TXY-2106/Mid-term-internship-10.1/firmware/esp32/qsm_monitor/README.md

# ESP32 网关（Arduino IDE）

功能：接收 STM32 的 `$QSM` 帧 → 连 Wi-Fi → 托管网页仪表板。**不做任何计数判定**。

## 环境准备

1. Arduino IDE → 文件 → 首选项 → 附加开发板管理器网址，填（国内镜像，走 `dl.espressif.cn`）：

   ```
   https://arduino.me/packages/esp32.json
   ```

2. 工具 → 开发板 → 开发板管理器 → 搜索 `esp32` → 安装 **esp32 by Espressif Systems `3.2.1-cn`**
3. 开发板选 **ESP32 Dev Module**，端口选 CH340 对应的 COM 口

> 镜像最高为 3.2.1，比官方 3.3.12 旧一个小版本，本项目功能不受影响。注意 ESP32 core **3.x 与 2.x 的部分 API 有差异**，查文档时看清版本。

## 打开与修改

1. 用 Arduino IDE 打开 `qsm_monitor/qsm_monitor.ino`（草图中所有 `.h/.cpp` 会一起编译）
2. 在 **`config.h`** 里选联网方式（**只改这一个数**）：

   ```c
   #define WIFI_MODE       1     /* 1=自建热点  2=连现场Wi-Fi  3=两者同时 */
   ```

   | 模式 | 地址 | 什么时候用 |
   |---|---|---|
   | `1` AP（**默认**） | `http://192.168.4.1` **永远不变** | **演示**：不依赖现场网络，插电就能用 |
   | `2` STA | 路由器分配的 IP，看串口打印 | 平时开发、要上网 |
   | `3` APSTA | 两者都有，热点兜底 | 想连现场网又怕连不上 |

   选 `2` 或 `3` 才需要填 `WIFI_SSID` / `WIFI_PASSWORD`；选 `1` 不用填任何 Wi-Fi。

   > **演示建议用模式 `1`**：ESP32 自己开热点 `QSM-Monitor`（密码 `qsm12345`），
   > 手机或笔记本连上它，浏览器打开 `http://192.168.4.1` 即可。
   > 这样你在**任何一台电脑上烧录一次**，之后插电就能演示，不用串口、不用找 IP、不依赖场地 Wi-Fi。
   > 手机若提示"此 WLAN 无法访问互联网"，选**保持连接**即可。

3. 上传

## 接线

依据仓库 [`hardware/硬件接线说明.md`](../../../hardware/硬件接线说明.md)：

| ESP32 | STM32 | 说明 |
|---|---|---|
| GPIO16 (U2RXD) | **PA2** (USART2_TX) | STM32 → ESP32 |
| GPIO17 (U2TXD) | **PA3** (USART2_RX) | ESP32 → STM32 |
| GND | GND | **必须共地** |
| Type-C | — | 充电宝供电（USB-A 转 Type-C） |
| VIN | 5V | 由 ESP32 的 VIN 分出 5V 给 STM32 / E18×4 / SD 卡座 |

> **不要**把 ESP32 的 3V3 与 STM32 的 3V3 并联；**不要**给 STM32 插 Type-C。
> ESP32 发射瞬时电流可达 300 mA，务必由充电宝独立供电并在模块旁加 470 µF 电容，否则会复位。

## 使用

上传后打开串口监视器（115200），会看到一张启动横幅，例如模式 `1` 时：

```
========================================
  排队状态监测器 已启动
  热点: QSM-Monitor   密码: qsm12345
  打开: http://192.168.4.1
  (手机提示"无互联网"时选"保持连接")
========================================
[QSM] http server started on port 80
```

模式 `2` / `3` 连上现场 Wi-Fi 时还会多打印一行 `[WiFi] connected, open http://192.168.x.x`。

**演示流程（模式 1，全程不需要电脑）**：

1. 充电宝给 ESP32 供电（Type-C），ESP32 的 VIN 分出 5V 给 STM32 / E18 / SD 卡
2. 手机或笔记本连 Wi-Fi `QSM-Monitor`，密码 `qsm12345`
3. 浏览器打开 `http://192.168.4.1`

浏览器即可看到仪表板：三级状态色块、在场人数、累计进出、两路探头遮挡时长、最近 2 分钟趋势条、拥挤告警。

> 若装了 Bonjour，也可以访问 `http://qsm.local`；**不确定就还是用 IP，IP 永远可用**。

## 现场常见问题

| 现象 | 原因 / 处理 |
|---|---|
| 手机连上热点却打不开 `192.168.4.1` | 手机把该热点当成"无互联网 WLAN"自动切回流量，关掉移动数据或选"保持连接" |
| 换了场地，`192.168.4.1` 打不开 | 你烧的是模式 `2`（STA），IP 变了；改回模式 `1` 重烧 |
| 网页一直显示"等待数据" | STM32 没在发帧：查 PA2→GPIO16 接线、共地、STM32 是否已烧录 |
| 热点开了但搜不到 | 密码少于 8 位会开热点失败，`AP_PASSWORD` 至少 8 个字符 |

## HTTP 接口

| 路径 | 说明 |
|---|---|
| `/` | 仪表板网页（内嵌，无外部依赖，断网可用） |
| `/api/state` | 最新状态 JSON，含链路统计与告警阈值 |

`/api/state` 示例：

```json
{"valid":true,"seq":1024,"ms":3735000,"datetime":"2026-10-28T12:31:04",
 "in":37,"out":29,"occ":8,"q50":6100,"q100":0,"grade":2,"flags":3,
 "good":1024,"bad":0,"age":450,"alert_grade":2,"alert_occ":8}
```

`good` / `bad` / `age` 三个字段是现场排障用的：`bad` 持续增长说明串口干扰或两端协议不一致，`age` 过大说明 STM32 掉线或没在发。

## 文件说明

| 文件 | 职责 |
|---|---|
| `qsm_monitor.ino` | 入口：初始化、主循环、Wi-Fi 后台重连 |
| `config.h` | Wi-Fi、串口引脚、历史长度、告警阈值 |
| `serial_link.cpp/.h` | 帧解析 + CRC8 校验（须与 `firmware/core/protocol.c` 一致） |
| `web_server.cpp/.h` | HTTP 路由与 JSON 序列化 |
| `web_page.h` | 内嵌 HTML/CSS/JS（单页，1 s 轮询） |

## 注意

- **CRC 算法两端必须一致**：改 `firmware/core/protocol.c` 的 `qsm_crc8` 时，必须同步改 `serial_link.cpp` 的同名函数。
- 网页用 1 s 轮询而非 WebSocket/SSE，是为了让整页逻辑足够短、便于现场排障；A3 要求 ≤5 s，余量充足。
- `config.h` 里的 `HISTORY_SIZE` 目前未用于服务端历史（趋势条在前端生成）；若要在服务端存 1 小时历史，需要再加环形缓冲与 `/api/history` 接口。
