TXY-2106/Mid-term-internship-10.1/docs/排队状态监测器——后期测试方案.docx

## 排队状态监测器——后期测试方案

项目名称：排队状态监测器

项目阶段：软件测试分析与后续实物测试准备

个人主要分工：后期测试、测试用例设计与测试结果整理

一、测试目的

通过分析测试代码，了解系统对人员进出方向、排队拥挤程度及通信数据的处理方式，整理对应的测试用例和预期结果，为后续四路红外传感器安装完成后的系统联调与实际场景测试提供依据。

二、项目当前测试基础

项目计划采用四路 E18-D80NK 红外光电传感器，其中两路用于判断人员进出方向，另外两路分别设置在队伍长度约50%和100%的位置，用于判断队伍拥挤程度。STM32 负责采集和处理传感器信号，ESP32 负责通信及网页展示。

目前已完成网页基本功能及单个红外传感器与 STM32 的初步连接，四路传感器的完整安装和系统联调仍需继续推进。

小组 GitHub 仓库已建立软件单元测试框架，主要包含以下文件：

1. test_gate_counter.c：用于测试人员进入、离开、重复触发、超时及方向判断等逻辑。

2. test_queue_grade.c：用于测试排队状态分级、状态切换延迟及异常情况处理。

3. test_protocol.c：用于测试通信数据编码、解析及 CRC 校验。

4. test_main.c：用于组织各模块测试并统计检查次数与失败次数。

5. test_util.h：提供 CHECK 和 CHECK_EQ 等测试判断工具。

6. Makefile：用于编译和运行软件单元测试。

根据 GitHub 项目 README 中的记录，现有软件测试共完成53项检查，记录结果为0项失败。该结果属于软件逻辑测试记录，不能直接代表完整硬件系统的实际测试结果。

三、软件测试用例设计

3.1 人员进出统计测试

编号 | 测试场景 | 测试操作或输入 | 预期结果
01 | 正常进入 | 依次触发入口检测区域的A、B两路信号 | 进入人数增加1
02 | 正常离开 | 按相反顺序触发B、A两路信号 | 离开人数增加1
03 | 触发间隔超时 | 两路信号间隔超过设定识别时间 | 不产生有效进出计数
04 | 单路信号触发 | 仅触发一路信号，另一信号未触发 | 超时后不计数
05 | 同一路重复触发 | 同一路信号在短时间内重复触发 | 不产生错误的完整进出计数
06 | 恢复遮挡过程 | 模拟传感器遮挡后恢复的信号变化 | 不因恢复过程错误改变进出方向
07 | 方向配置反转 | 修改方向配置并输入相同触发顺序 | 进出方向按照配置正确变化
08 | 离开人数多于进入人数 | 在当前人数为0时模拟离开 | 当前在场人数不小于0

3.2 排队拥挤程度分级测试

系统设计将排队状态划分为“较少、约半、全满”三级。

编号 | 测试场景 | 测试操作或输入 | 预期结果
09 | 初始状态 | 初始化排队分级模块 | 显示“较少”
10 | 50%位置持续遮挡 | 模拟中部传感器持续被遮挡 | 达到设定持续时间后变为“约半”
11 | 100%位置持续遮挡 | 模拟末端传感器持续被遮挡 | 达到设定条件后变为“全满”
12 | 短时间遮挡 | 遮挡时间未达到设定阈值即恢复 | 不因短暂经过而错误升级
13 | 遮挡解除 | 模拟传感器从遮挡恢复到未遮挡 | 达到设定释放时间后调整状态
14 | 状态交叉校验 | 末端传感器遮挡，但实际在场人数不足 | 记录冲突，不直接错误

判定为全满

3.3 通信协议测试

15 | 正常编码 | 输入合法人数、时间及状态数据 | 生成符合协议格式的数据帧
16 | 正常解析 | 输入符合格式的数据帧 | 正确解析对应字段
17 | CRC校验 | 输入包含正确CRC的数据帧 | 校验通过
18 | 数据损坏 | 修改数据内容但不更新CRC | 识别校验错误
19 | 非法输入 | 输入错误格式或不完整的数据帧 | 拒绝非法数据，避免错误更新状态

四、后续真实硬件测试计划

由于四路红外传感器尚未完成整体安装，本部分主要用于后续实物联调阶段。

编号 | 测试项目 | 测试方法 | 预期结果
01 | 单人进入测试 | 一人按正常方向通过检测区域 | 人数正确增加
02 | 单人离开测试 | 一人按相反方向通过检测区域 | 人数正确减少
03 | 连续通过测试 | 多人依次通过检测区域 | 计数与实际人数一致
04 | 两人并排测试 | 两人同时通过检测区域 | 记录实际识别结果，分析漏计或误计情况
05 | 通信异常测试 | 模拟ESP32断线、重连等情况 | 检查通信恢复及数据显示情况
06 | 网页状态核对 | 对照真实人数和传感器状态查看网页 | 显示结果与实际状态相符，记录更新延迟

以上测试需要在真实硬件条件具备后开展。测试过程中应记录实际结果，不能仅根据软件逻辑推断硬件测试通过。

五、个人测试记录表

测试日期 | 测试编号 | 测试环境 | 预期结果 | 实际结果 | 是否通过 | 问题及证据

六、当前存在的问题及后续安排

1. 四路红外传感器尚未完成整体安装，真实环境下的进出计数与排队分级准确性仍需验证。

2. 软件单元测试采用模拟输入，尚不能反映实际传感器受安装距离、人员速度和并排行走影响时的识别情况。

3. 网页显示与真实传感器数据之间的完整联动效果、更新延迟及长时间运行稳定性仍需进一步确认。

4. 后续计划配合小组完成硬件联调，按照测试用例开展重复实验，记录实际人数、系统计数、显示状态和异常现象，并对发现的问题进行复测。
