TXY-2106/Mid-term-internship-10.1/docs/排队状态监测器项目中期评审会议纪要.docx

## 排队状态监测器项目中期评审会议纪要

项目名称： 排队状态监测器

小组： 第一组

会议时间：2026年10月31日（第九周周六）

会议地点：电气楼330

会议形式：项目中期进度汇报与教师评审

参会人员：小组全体成员：谭心宇、叶明昌孝、丁秋月、张岩超

指导教师：崔磊磊

记录人： 丁秋月

一、会议主要内容

本次会议主要围绕排队状态监测器项目的阶段性开发成果、当前存在的问题以及后续改进方向展开。小组通过PPT汇报了项目背景、功能需求、软硬件设计方案、人员分工、当前开发进度及后续测试计划，并听取了指导教师的意见。

二、项目当前进展

1.系统设计方面： 项目采用红外传感器进行非图像式检测，以保护用户隐私。计划使用四个红外传感器，其中入口设置两个，用于辅助判断人员进出；队伍中间和末端各设置一个，用于判断队伍的排队状态。

2.硬件开发方面： 已完成一个红外传感器与STM32主板的连接，其他传感器尚未完成安装。系统设计中还包括ESP32通信模块、DS3231时钟模块及SD卡存储模块。

3.软件开发方面： 已完成网页基本功能，实现排队人数及“少、一半、满”三档状态的显示。

4.阶段性测试方面： 已打通单个红外传感器、STM32、ESP32与网页之间的基本数据传输链路。在单传感器台架测试中，进行了10次挥手触发测试，10次均正确计数。

5.当前存在的问题： 网页更新存在约4—5秒的延迟，四个红外传感器尚未完成整体安装，三档状态准确率及系统连续运行稳定性仍需进一步验证。

6.目前已建立软件单元测试框架，覆盖进出人数统计、排队拥挤程度分级和通信协议等功能；GitHub 项目文档记录53项检查通过，后续仍需结合完整硬件开展实际场景测试。

三、指导教师提出的意见

1.增加排队情况预测功能

指导教师建议在现有排队状态监测功能的基础上，进一步考虑预测排队情况，使系统不仅能够显示当前队伍状态，还能够为用户提供未来排队变化或等待情况的参考。

2.优化硬件安装与连接方式

指导教师建议将四个红外传感器的连接集中到统一电路板上，采用焊接方式进行固定，减少分散接线，提高硬件结构的整洁性、稳定性和后续维护便利性。具体采用PCB还是洞洞板，需进一步确认。

3.增加现场显示方式

指导教师建议在现有网页显示功能的基础上，考虑增加实体显示屏，使现场排队人员也能够直接查看当前排队人数及状态，提高系统在实际排队场景中的实用性。

四、小组讨论与初步改进方向

针对教师提出的意见，小组拟在保留现有系统基本功能的前提下，进一步完善软硬件设计。

在功能方面，研究排队预测功能的实现方式，结合人数变化和排队速度等信息，评估是否能够提供预计等待时间或排队趋势。

在硬件方面，进一步讨论四个红外传感器的集中安装方式，完善接线布局，并优先完成四路传感器的连接与调试。

在显示方面，研究现有网页与实体显示屏结合的可行性，考虑使用适合现场观看的显示设备，展示排队人数及三档状态。

同时，继续解决网页更新延迟问题，逐步开展准确率、异常情况和系统稳定性测试。

五、会议总结

通过本次中期评审，小组明确了项目当前取得的阶段性成果和仍需解决的问题。指导教师的意见为后续功能拓展、硬件结构优化和实际应用场景设计提供了方向。

下一阶段，小组将优先完成四路传感器安装、数据传输优化和系统功能测试，并根据开发时间与实际条件评估预测功能和现场显示屏的实现可行性。
