TXY-2106/Mid-term-internship-10.1/hardware/制版文件/2D平面图.png

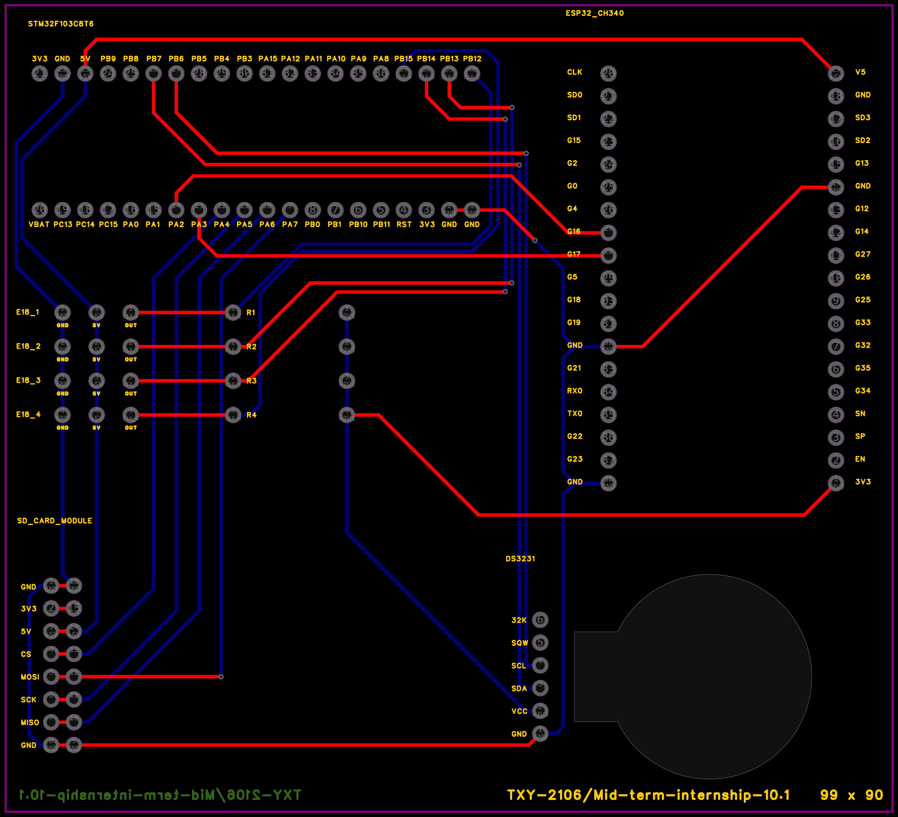
hardware/制版文件/2D平面图.png
