TXY-2106/Mid-term-internship-10.1/docs/post-testing plan.docx

## Queue status monitor—post-testing plan

Project Name: Queue Status Monitor

Project phase: software testing analysis and subsequent physical testing preparation

My main responsibilities: post-stage testing, designing test cases, and organizing test results

1. Purpose of the Test

By analyzing the test code, the system understands how the system handles personnel entry and exit directions, queue congestion, and communication data, organizes corresponding test cases and expected results, and provides a basis for system joint debugging and real-world testing after the installation of four infrared sensors

2. Current testing foundation for the project

The project plans to use four E18-D80NK infrared photoelectric sensors: two to determine the direction of personnel entering and exiting, and the other two to be set at about 50% and 100% of the queue length respectively to assess crowding levels. STM32 is responsible for collecting and processing sensor signals, while ESP32 is responsible for communication and web display

Currently, basic web functions and the initial connection of a single infrared sensor to STM32 have been completed. The complete installation of four sensors and system integration still require further progress

The group GitHub repository has established a software unit testing framework, mainly consisting of the following files:

1. test_gate_counter.c: Used to test logic such as personnel entering, leaving, repeated triggers, timeouts, and direction judgment.

2. test_queue_grade.c: Used to test queue status grading, state switching delay, and exception handling.

3. test_protocol.c: Used for testing communication data encoding, parsing, and CRC verification.

4. test_main.c: Used to organize testing for each module and count the number of inspections and failures.

5. test_util.h: Provides test and judgment tools such as CHECK and CHECK_EQ.

6. Makefile: Used for compiling and running software unit tests.

According to the records in the GitHub project README, a total of 53 checks have been completed in the existing software test, with zero failures. These results belong to software logic test records and cannot directly represent the actual test results of the complete hardware system.

3. Software Test Case Design

3.1 Personnel entry and exit statistical testing

Number | Test scenario | Test operations or inputs | Expected results
01 | Normal entry | Trigger signals A and B in sequence at the entrance detection area | Number of entrants increased by 1
02 | Leave as usual | Trigger signals B and A in reverse order | Number of departures increased by 1
03 | Trigger interval timeout | The interval between two signals exceeds the set recognition time | No effective in-exit count is generated
04 | Single-channel signal trigger | Only one signal is triggered; the other signal is not triggered | Beyond the time limit is not counted
05 | Trigger the same path repeatedly | The same signal is repeatedly triggered within a short period | No incorrect complete in-out counts are produced
06 | Restore the occlusion process | Analog signal changes after sensor occlusion | Do not change the direction of entry and exit due to errors during the recovery process
07 | Directional configuration reversal | Modify the direction configuration and enter the same trigger sequence | The direction of entry and exit changes according to the correct configuration
08 | More people left than entered | Simulate leaving when the current number of players is 0 | The current number of attendees is no less than 0

3.2 Grading Test for Queue Crowd Level

The system design divides queue status into three levels: "Smaller," "About Half," and "Fully Full."

Number | Test scenario | Test operations or inputs | Expected results
09 | Initial state | Initialize the queue grading module | Show "Less"
10 | 50% of the area remains occluded | The simulated central sensor is continuously obscured | After reaching the set duration, it becomes "about half"
11 | 100% position continuously occluded | The analog end-point sensor is continuously obscured | After meeting the set conditions, it becomes "fully full"
12 | Cover for a short time | Restoration occurs before the occlusion time reaches the set threshold | Do not upgrade mistakenly just because of a brief pass
13 | Obstruction removed | The analog sensor recovers from occlusion to unmasked | Adjust the status after reaching the set release time
14 | Status cross-check | The terminal sensors are obstructed, but the actual number of people present is insufficient | Record conflicts, do not make direct mistakes

The judgment was fully booked

3.3 Communication protocol testing

15 | Normal encoding | Enter the number of legitimate people, time, and status data | Generate data frames that comply with protocol format
16 | Normal analysis | Enter data frames that match the format | Correctly parse the corresponding fields
17 | CRC verification | Enter a data frame containing the correct CRC | Verification passed
18 | Data corruption | Modifying data content but not updating CRC | Identify validation errors
19 | Illegal input | Incorrect formatting or incomplete data frames | Reject illegal data to avoid erroneous state updates

4. Subsequent real hardware testing plans

Since the overall installation of the four infrared sensors has not yet been completed, this section is mainly used for the subsequent physical integration phase.

Number | Test items | Testing methods | Expected results
01 | Single-entry testing | One person passes through the inspection area in the normal direction | The number of people has increased correctly
02 | Solo leave for testing | One person passes through the inspection area in the opposite direction | The number of people is rightly reduced
03 | Passing tests continuously | Multiple people passed through the inspection area in sequence | The count matches the actual number of people
04 | Two people tested side by side | Both passed through the inspection area simultaneously | Record the actual recognition results and analyze any undercounts or errors
05 | Communication anomaly testing | Simulating ESP32 disconnection and reconnection scenarios | Check communication recovery and data display
06 | Web page status check | View the webpage against the actual number of people and sensor status | The display results match the actual status, and the update delay is recorded

The above tests must be conducted only after actual hardware conditions are met. The actual results should be recorded during testing; passing hardware tests should not be inferred solely based on software logic.

5. Personal Test Record Sheet

Test date | Test number | Testing environment | Expected results | The actual result | Whether it passes | Issues and evidence

6. Current Issues and Follow-up Arrangements

1. The four-channel infrared sensors have not yet been fully installed; the accuracy of entry and exit counting and queue grading in real environments still needs to be verified.

2. Software unit tests use analog inputs and cannot yet reflect the recognition of actual sensors affected by installation distance, personnel speed, and parallel walking.

3. The complete linkage between webpage display and real sensor data, update delay, and long-term operation stability still require further confirmation.

4. Subsequent plans include cooperating with the team to complete hardware joint debugging, conduct repeated experiments according to test cases, record actual number of people, system counts, display status and abnormal phenomena, and retest any issues found.
