TXY-2106/Mid-term-internship-10.1/(commit log)

2026-09-26 补充项目概要、验收标准与时间线
    Updated the README to reflect project details and acceptance criteria in Chinese.
2026-09-26 添加英文版 README（README.en.md）
2026-09-26 README 顶部添加中英双语切换标签
2026-10-12 同步已确定的技术方案、docs 跳转链接，A1 调整为 ≤ ±2 人
    Updated project details and acceptance criteria in README.md. Added technical solution section and refined privacy compliance criteria.
2026-10-13 技术方案修正：热成像改为红外线识别
    Updated project details and technical方案 in README.
2026-10-23 重写 README：对齐当前红外 + 双板方案，移除时间线，新增成本控制
2026-10-23 改用大卡 SD 模块与自有 32GB 卡，更新成本估算
2026-10-23 SD 卡按市面价列示但不计入合计；补充容量测算与 8GB 推荐
2026-10-23 List SD card at market price but exclude from total; add capacity estimate and 8 GB recommendation
2026-10-23 标题改为排队状态监测器
2026-10-26 Create hardware wiring instructions document
    Added detailed hardware wiring instructions for STM32F103C8T6, ESP32-WROOM-32, E18-D80NK, DS3231, and SD card module.
2026-10-26 Create Hardware Wiring Instructions document
    Added detailed wiring instructions for STM32, ESP32, and peripherals including power connections, pin assignments, and module wiring.
2026-10-27 README 改为折叠式；新增硬件与文档索引入口；清理合并残留
2026-10-27 项目概要前四块常显；用户与受益者移至项目任务后；其余内容折叠
2026-10-27 Revise retail price estimation details in README
    Updated pricing information for STM32F103C8T6 minimum system board.
2026-10-27 Update VIN to V5/VIN in wiring instructions
2026-10-27 Clarify wiring instructions for power connections
2026-10-29 改变文档名
    经同意将文档名改为文档索引
2026-10-30 feat(esp32): AP mode with fixed 192.168.4.1 so the dashboard works on power-up
2026-11-03 docs: A4 稳定性改为连续运行 3 小时，并补制版文件入口
2026-11-03 docs: 新建制版文件目录与说明
2026-11-03 添加了PCB版
2026-11-03 Update file names and board parameters in README
2026-11-03 docs: 补充 E18 上拉阻值 4.7–10k 选用说明
2026-11-03 p cp文件进行了一些更新,优化了排线
2026-11-03 刚刚上传了旧文件,很抱歉,现在传的是新的
